TAKE-HooJoo/tr10_sram/cell/snm/Figure_1.png

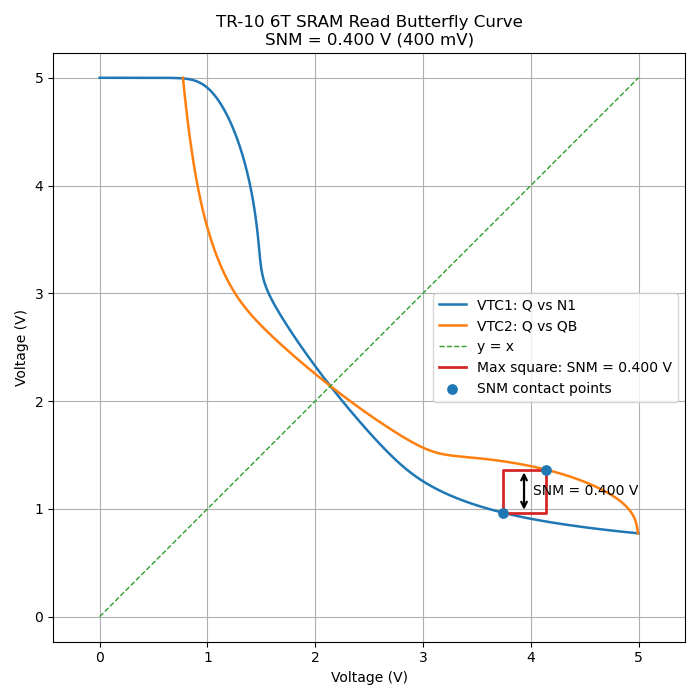
cell/snm/Figure_1.png
