TAKE-HooJoo/tr10_sram/cell/snm/read_snm_extraction.png

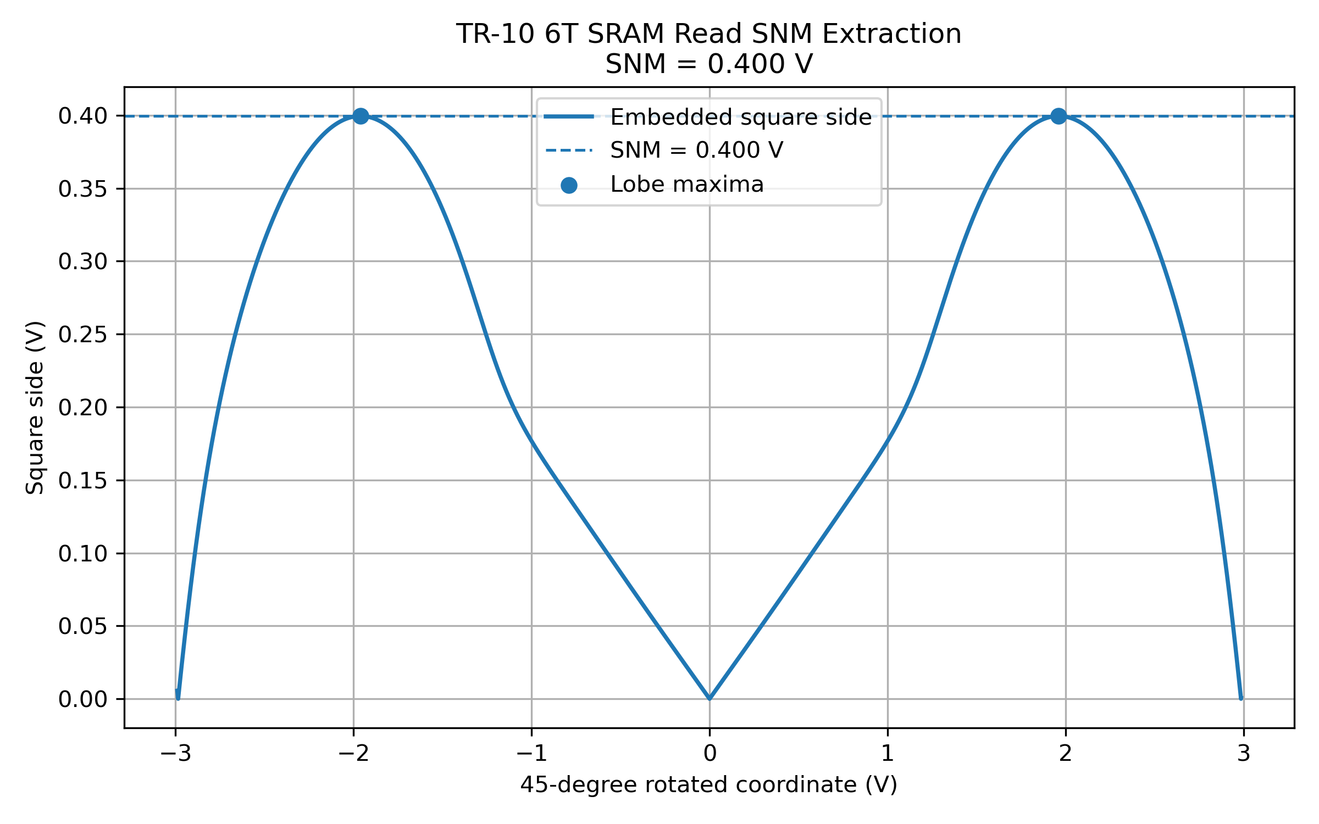
cell/snm/read_snm_extraction.png
