TAKE-HooJoo/tr10_sram/cell/snm/read_snm_geometric_check.png

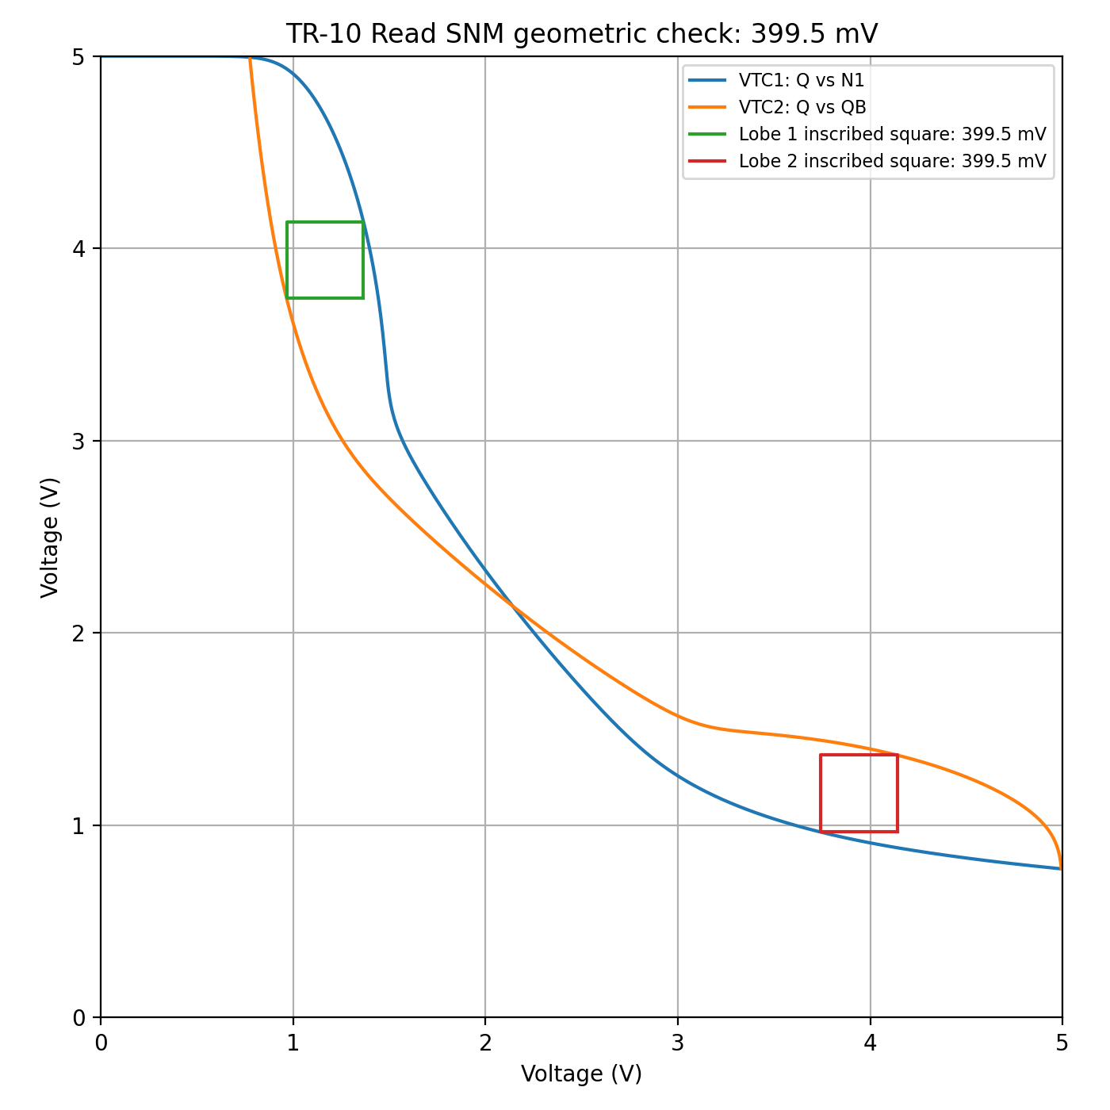
cell/snm/read_snm_geometric_check.png
