TAKE-HooJoo/tr10_sram/cell/snm/snm_001_myspice.png

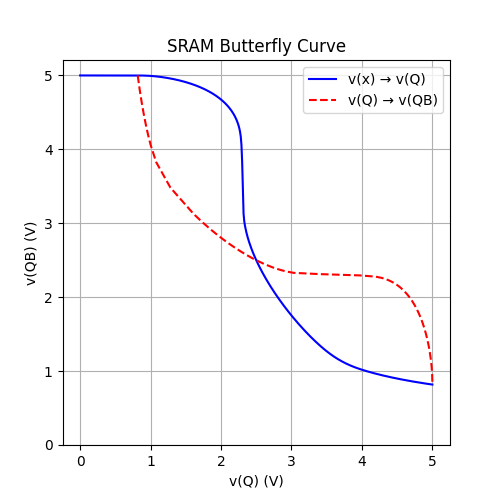
cell/snm/snm_001_myspice.png
