TAKE-HooJoo/tr10_sram/cell/snm/snm_butterfly.png

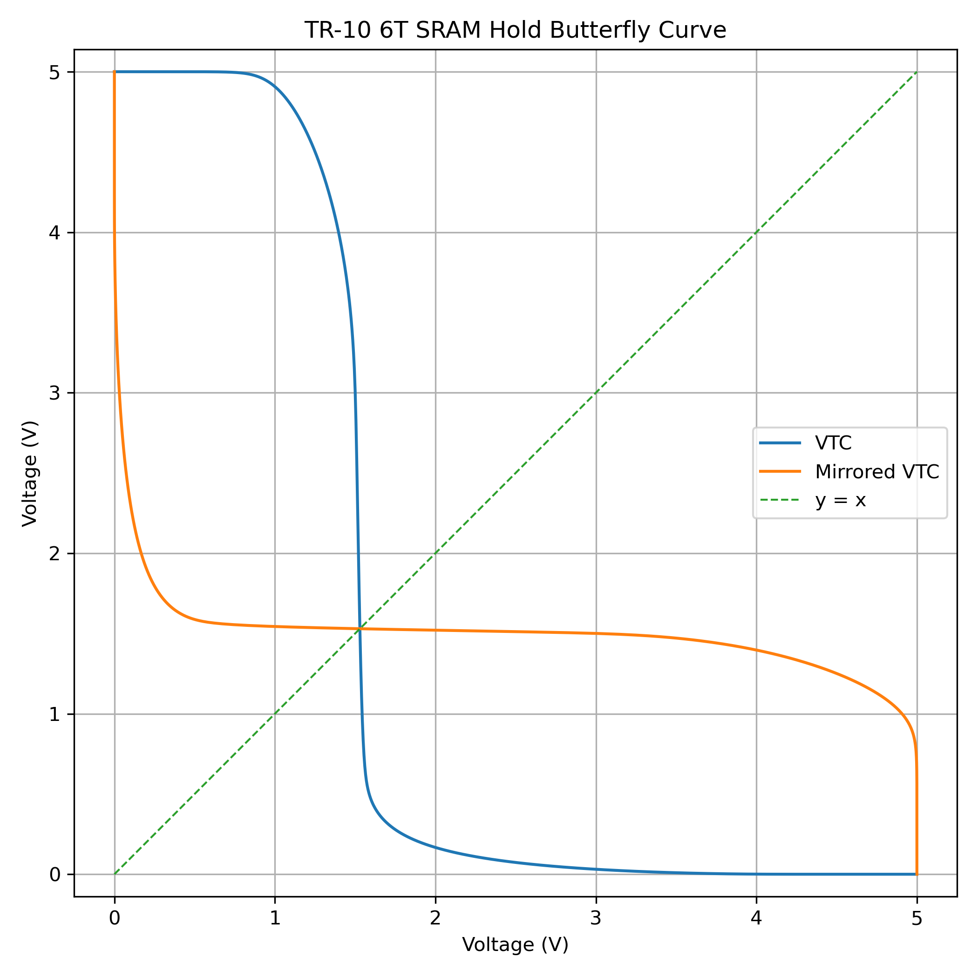
cell/snm/snm_butterfly.png
