TAKE-HooJoo/tr10_sram/cell/snm/snm_butterfly_square.png

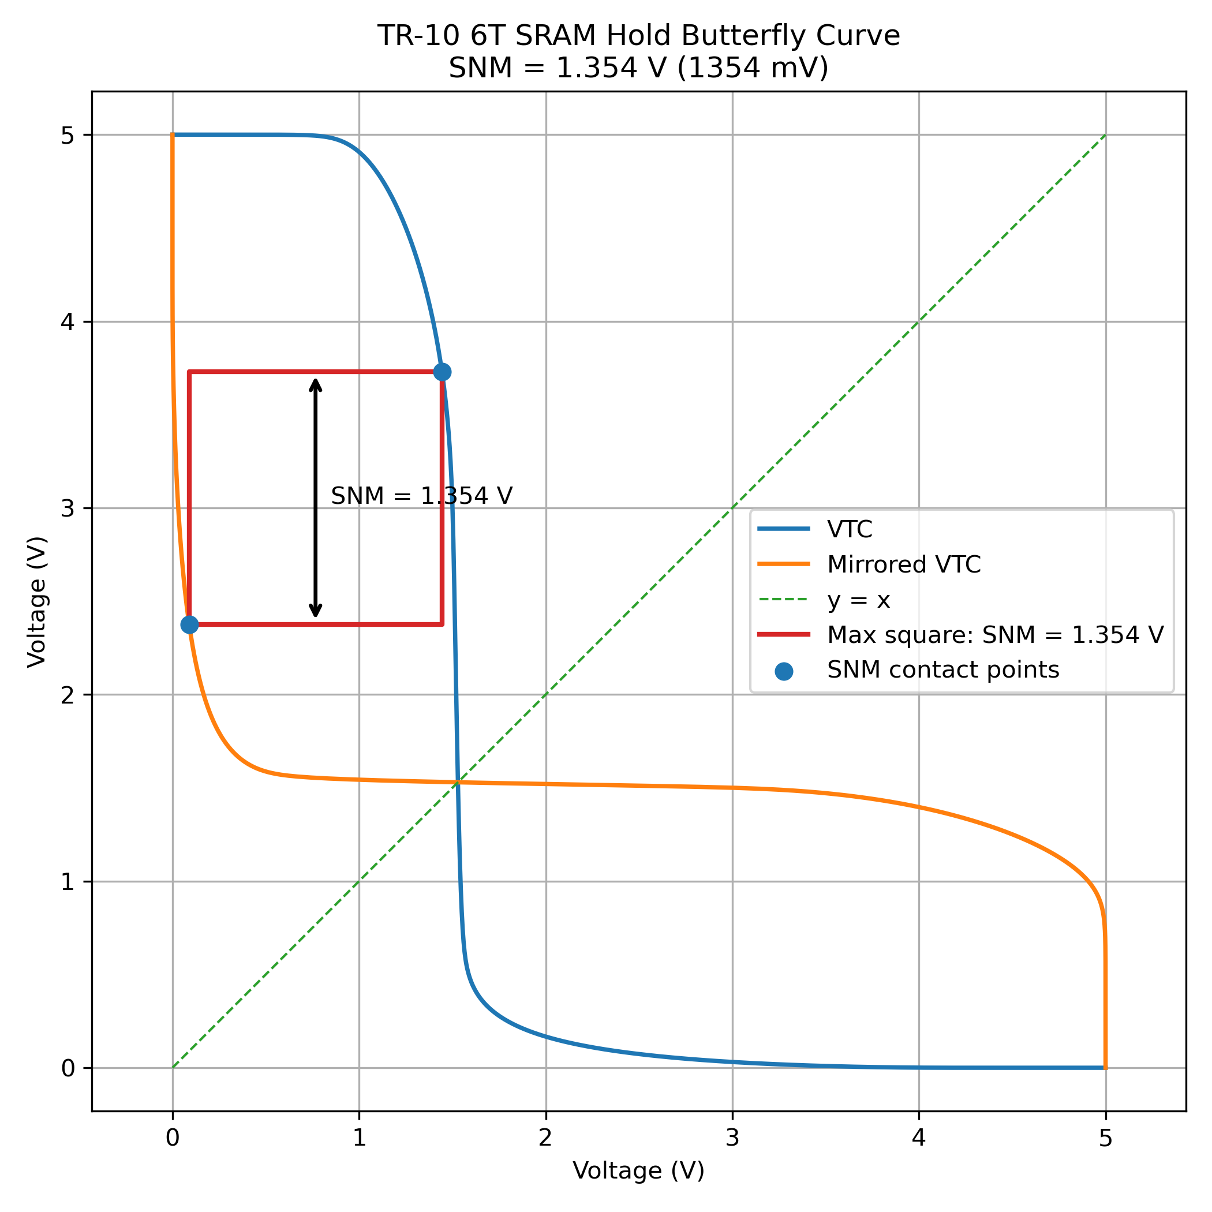
cell/snm/snm_butterfly_square.png
