TAKE-HooJoo/tr10_sram/cell/snm/snm_extraction.png

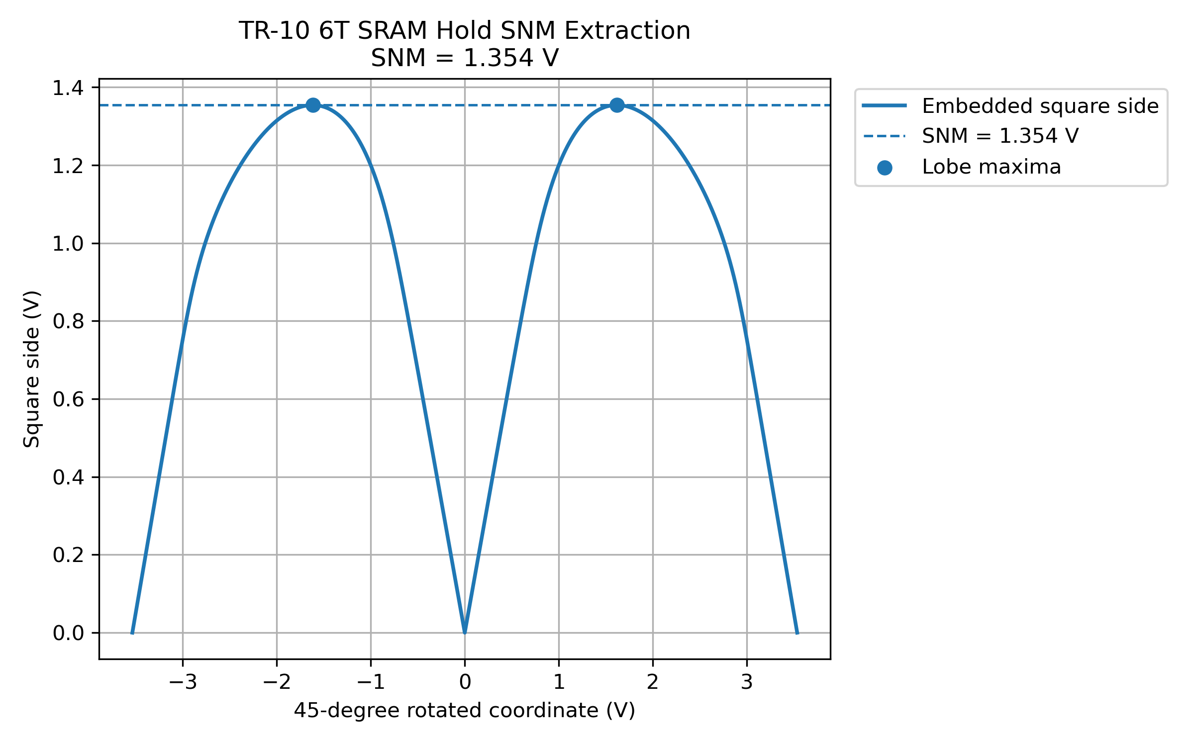
cell/snm/snm_extraction.png
