TAKE-HooJoo/tr10_sram/cell/snm/sramsnm.png

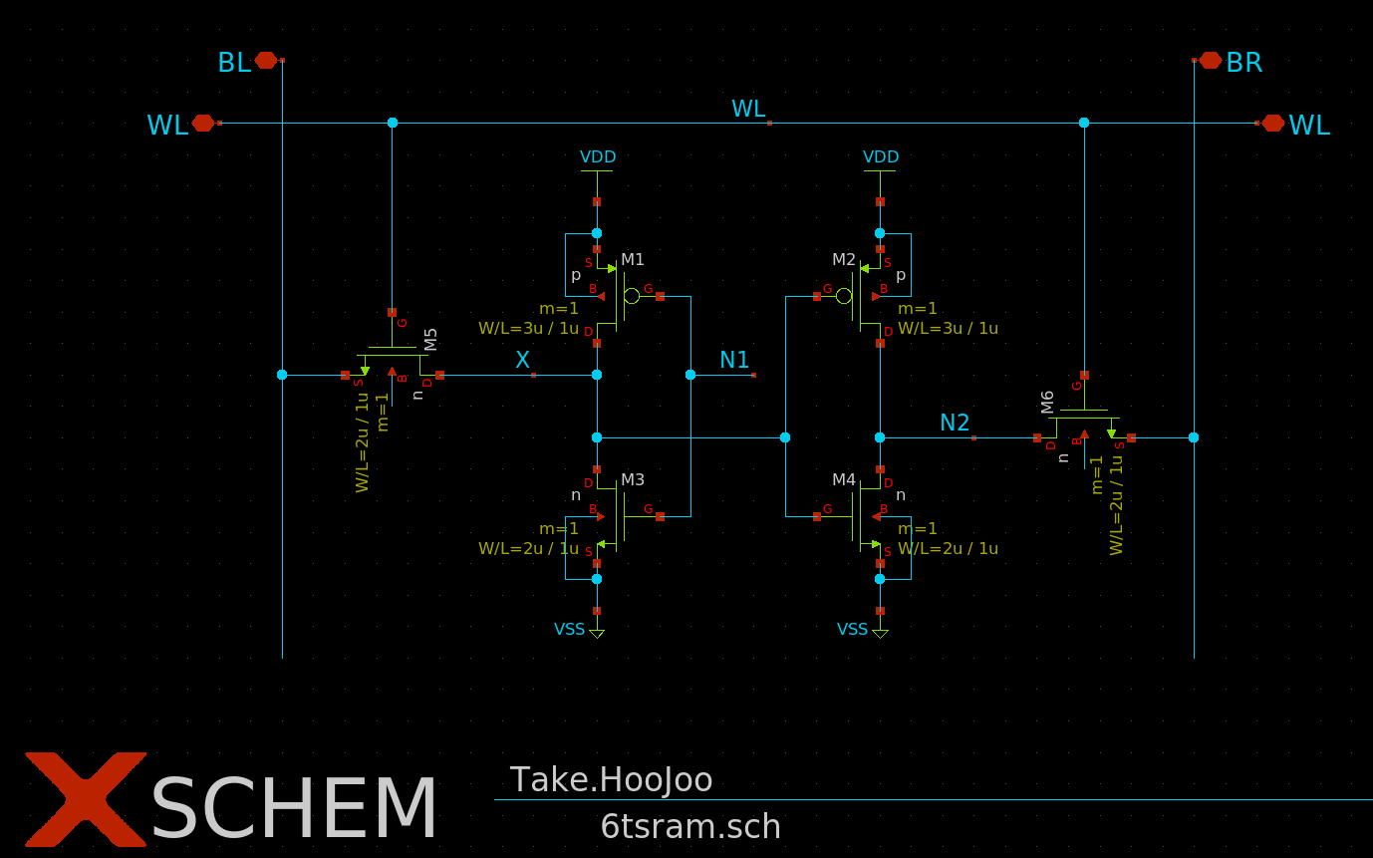
cell/snm/sramsnm.png
