TAKE-HooJoo/tr10_sram/docs/images/5t_sense_amp_dvbl_vs_delay.png

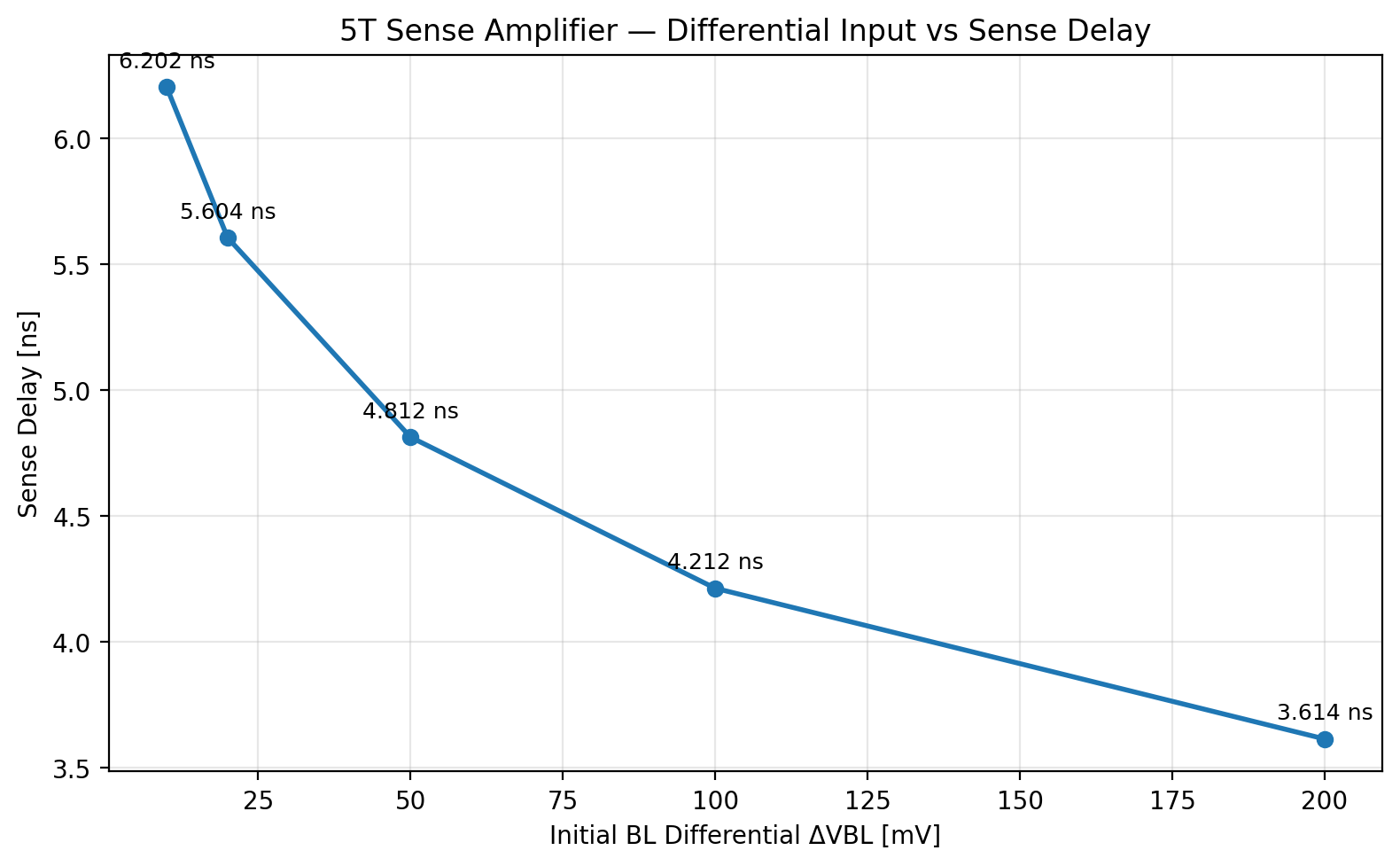
docs/images/5t_sense_amp_dvbl_vs_delay.png
