TAKE-HooJoo/tr10_sram/docs/images/6tsram.png

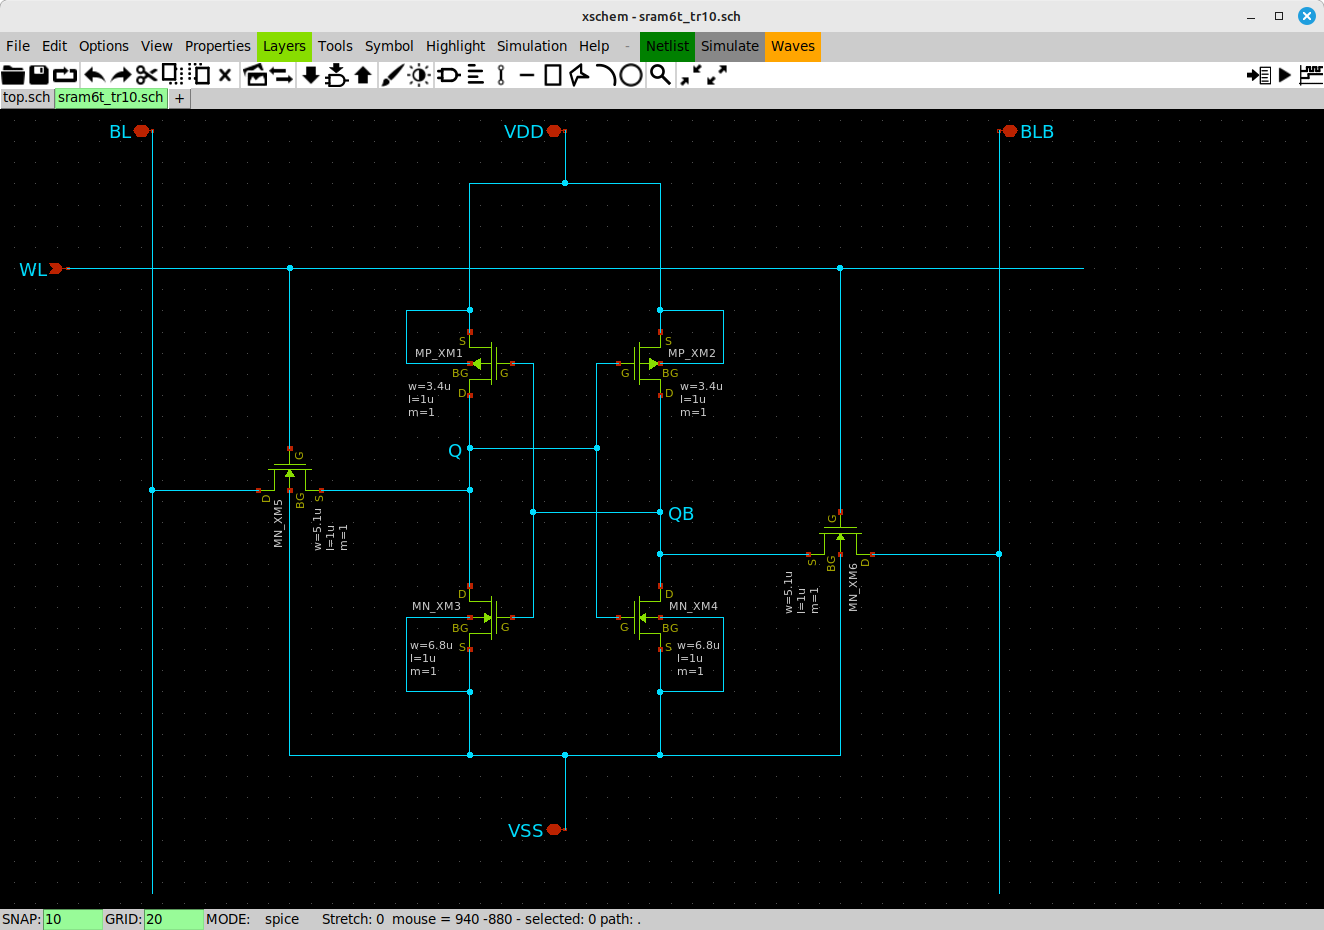
docs/images/6tsram.png
