TAKE-HooJoo/tr10_sram/docs/images/6tsram_a.png

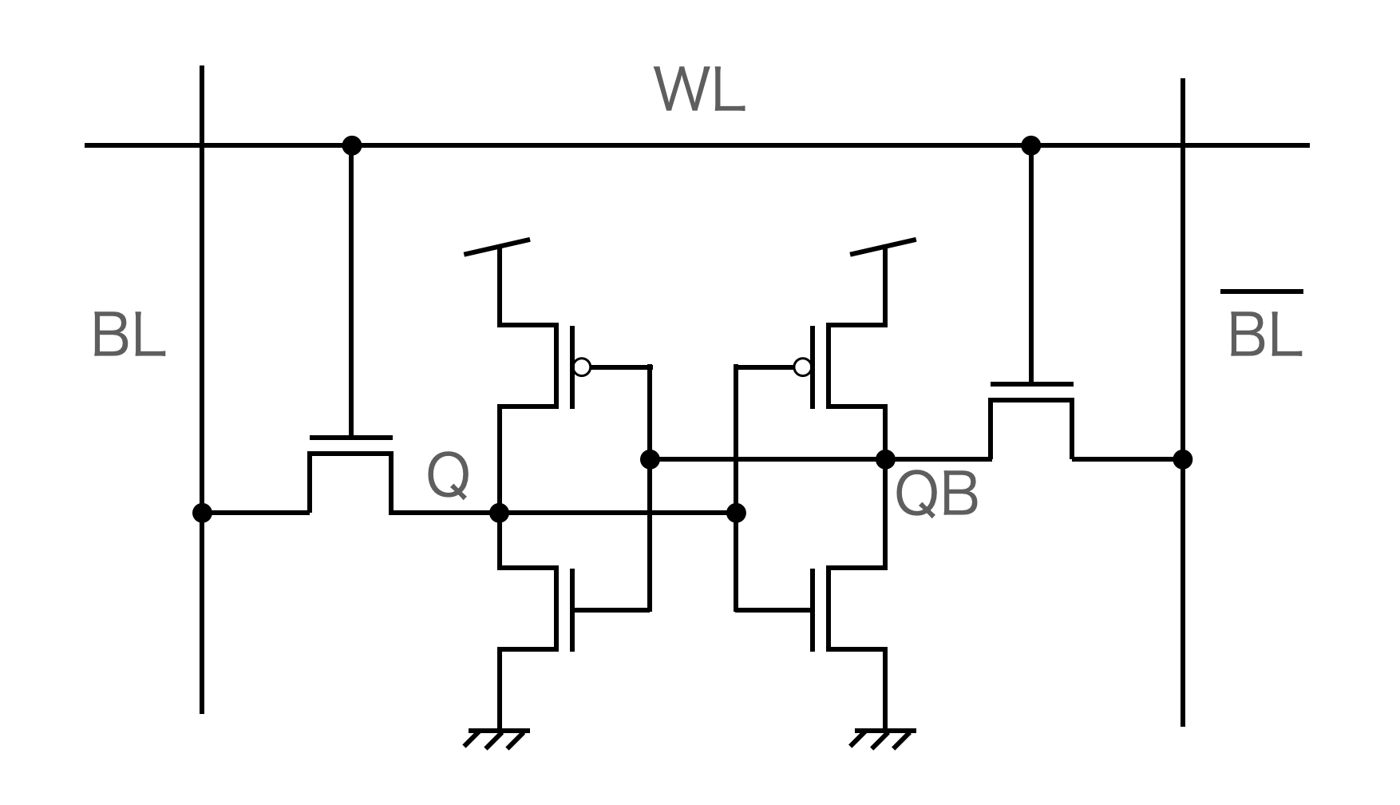
docs/images/6tsram_a.png
