TAKE-HooJoo/tr10_sram/docs/images/finalgds.png

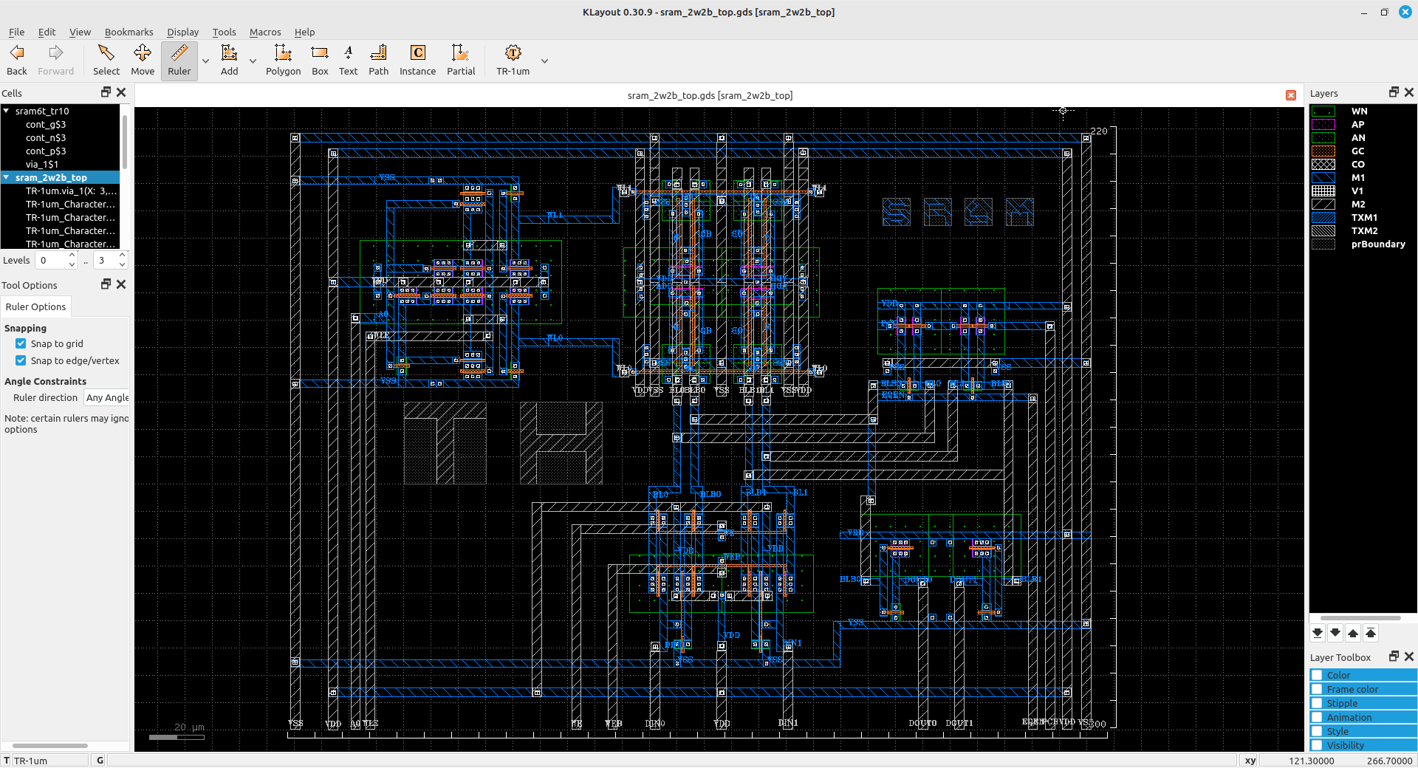
docs/images/finalgds.png
