TAKE-HooJoo/tr10_sram/docs/images/sa1.png

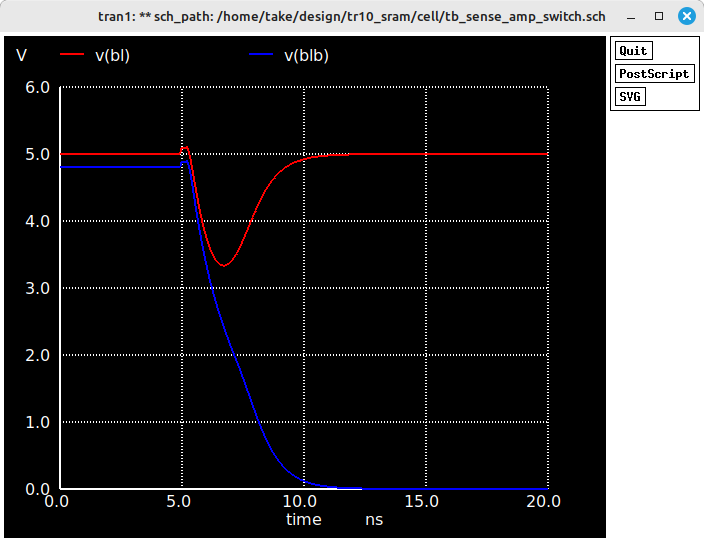
docs/images/sa1.png
