TAKE-HooJoo/tr10_sram/docs/images/Screenshot_from_2024-02-02_21-12-17.png

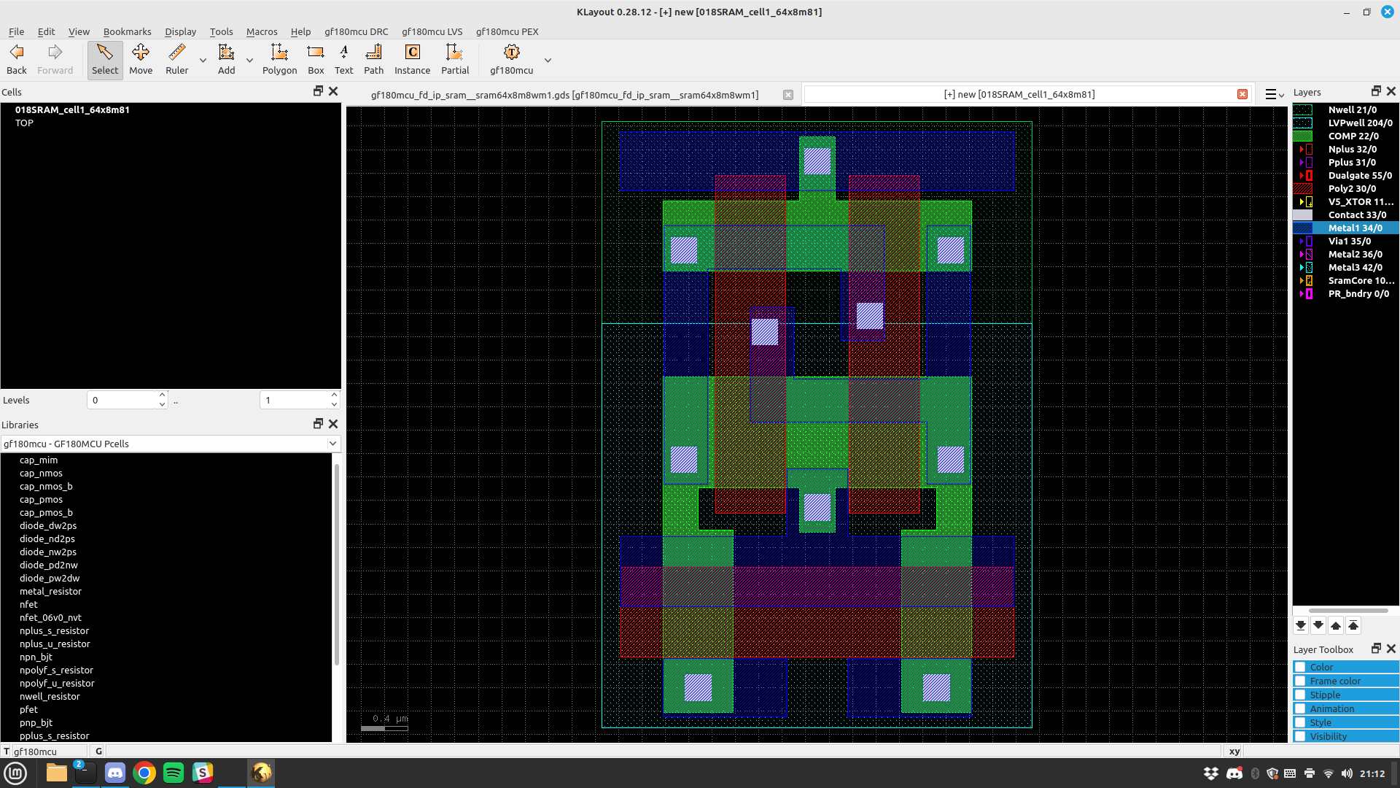
docs/images/Screenshot_from_2024-02-02_21-12-17.png
