TAKE-HooJoo/tr10_sram/docs/images/Screenshot_from_2024-02-02_23-55-41.png

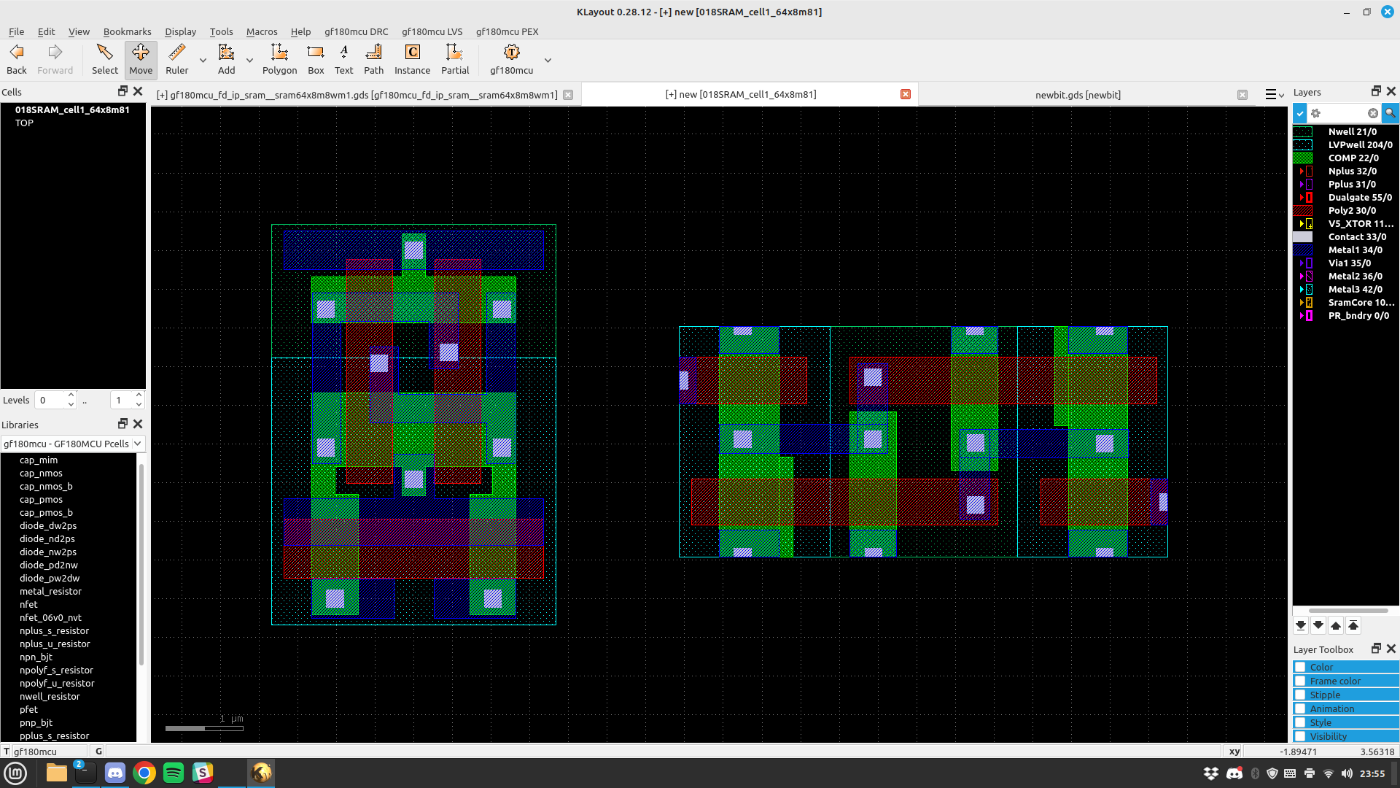
docs/images/Screenshot_from_2024-02-02_23-55-41.png
