TAKE-HooJoo/tr10_sram/(commit log)

2026-09-05 Add generic directories
    [inv.sch, nand2.sch, readpc.sch, rowdec.sch, sram6t.sch, sram6t_tr10.sch, sram_2x2_top.sch, tb_sram6t_write_read_v3.sch]
2026-09-05 Add TR-10 6T SRAM cell schematic
    [untitled.sch]
2026-09-05 Verify TR-10 6T SRAM Write 1 and hold operation
    [tb_hold.sch]
2026-09-05 Verify TR-10 6T SRAM write 0 and write 1 operation
    [tb_write.sch]
2026-09-05 Add 6T SRAM read test with PMOS precharge
    [tb_read_precharge.sch]
2026-09-05 Add equalized precharge SRAM read test
    [tb_read_equalize.sch]
2026-09-05 Verify 5T sense amplifier with 200mV differential input
    [sense_amp.sch, tb_read_dvbl.sch, tb_sense_amp.sch, tb_sense_amp_switch.sch, untitled.sch]
2026-09-05 Evaluate 5T sense amplifier sensitivity and delay
    [tb_sense_amp_sensitivity.sch]
2026-09-06 Add 2-word x 2-bit SRAM cell array
    [sram_2w2b.sch, tb_read_buffer.sch, tb_read_sense.sch]
2026-09-06 Verify 2word x 2bit SRAM write and read buffer operation
    [tb_read_buffer.sch, tb_read_precharge.sch, tb_sram_2w2b.sch]
2026-09-06 Verify 2word x 2bit SRAM write and read operation
    [tb_sram_2w2b.sch]
2026-09-06 Integrate WLE decoder into 2word x 2bit SRAM
    [decoder.sch, tb_decoder.sch, tb_sram_2w2b.sch]
2026-09-06 Add and verify 2-bit SRAM write driver
    [tb_write_driver.sch, write_driver.sch]
2026-09-06 Integrate write driver into 2word x 2bit SRAM
    [tb_sram_2w2b_01.sch]
2026-09-06 Add precharge equalize block to 2word x 2bit SRAM
    [precharge.sch, tb_sram_2w2b_02.sch, untitled.sch]
2026-09-06 Complete hierarchical 2word x 2bit SRAM integration
    [read_buffer.sch, tb_sram_2w2b_03.sch]
2026-09-07 Complete TR-10 6T SRAM bitcell layout with clean DRC and LVS
    [bitcell.sch]
2026-09-10 Add LVS-clean SRAM core, precharge and write driver layouts
    [write_driver.sch]
2026-09-11 Complete LVS-clean 2-word x 2-bit SRAM top layout
    [precharge.sch, sram_2w2b_top.sch]
2026-09-12 Update README for TR-10 SRAM submission
    [decoder.sch, precharge.sch, read_buffer.sch, sram_2w2b.sch, sram_2w2b_top.sch, tb_decoder.sch, tb_sram_2w2b.sch, tb_sram_2w2b_01.sch]
2026-09-12 Add hold and read SNM analysis for TR-10 SRAM
    [sram6t_tr10.sch, tb_read_snm.sch, tb_snm.sch]
2026-09-14 Add initial scan interface experiments
    [scan_shift6.sch, tb_scan_shift6.sch, untitled-1.sch]
2026-09-16 Generate WEB internally from WE for SRAM write control
    [DLYINV4.sch, dlyinv4.sch, scan_shift6.sch, sram_2w2b_top.sch, tb_scan_shift6.sch, tb_sram_2w2b.sch]
2026-09-17 Simplify SRAM controls with internal WEB and EQEN generation
    [sram_2w2b_top.sch, tb_sram_2w2b_04.sch]
2026-09-20 Add 8-word x 2-bit SRAM and read performance evaluation
    [decoder.sch, dlyinv4.sch, precharge.sch, read_buffer.sch, scan_shift6.sch, sram_2w2b.sch, sram_2w2b_top.sch, sram_8w2b.sch]
2026-09-20 Update README with 8-word SRAM evaluation and 10-pin I/O
2026-09-20 Complete LVS-clean 8-word x 2-bit SRAM top layout
    [sram6t_tr10.sch, sram_2w2b.sch, sram_8w2b.sch]
2026-09-20 Add 2-word x 8-bit ColMax SRAM and simulation results
    [decoder.sch, dlyinv4.sch, precharge.sch, read_buffer.sch, scan_shift6.sch, sram6t_tr10.sch, sram_2w2b.sch, sram_2w2b_top.sch]
2026-09-21 Optimize 2w8b SRAM read path for edge-bit observation
    [decoder.sch, dlyinv4.sch, precharge.sch, read_buffer.sch, sram6t_tr10.sch, sram_2w2b.sch, sram_2w2b_top.sch, sram_2w8b.sch]
2026-09-21 Verify 2w8b SRAM edge-bit read operation
    [sram_2w8b_top.sch, sram_2w8b_top_fullio.sch, tb_sram_2w8b_fullio.sch]
2026-09-21 Complete functional simulation of 2w16b SRAM
    [sram_2w16b.sch, sram_2w16b_top.sch, tb_sram_2w16b.sch]
2026-09-21 Complete DRC/LVS-clean 2w16b SRAM Colmax
    [sram_2w16b_top.sch]
2026-09-21 Complete DRC/LVS-clean 16w2b SRAM Rowmax
    [sram_16w2b.sch, sram_16w2b_top.sch, tb_sram_16w2b.sch]
2026-09-21 Complete DRC/LVS-clean 16w16b SRAM Capmax
    [sram_16w16b.sch, sram_16w16b_org.sch, sram_16w16b_top.sch, tb_sram_16w16b.sch, untitled.sch]
2026-09-22 Save SRAM TEG integration before flattening
    [sram_16w16b_top.sch, sram_2w16b_top.sch, sram_2w2b.sch, sram_teg_top.sch]
